leandroassis/laspi-door/Documentação/caixa_de_iluminação_e_fonte_12V.jpeg

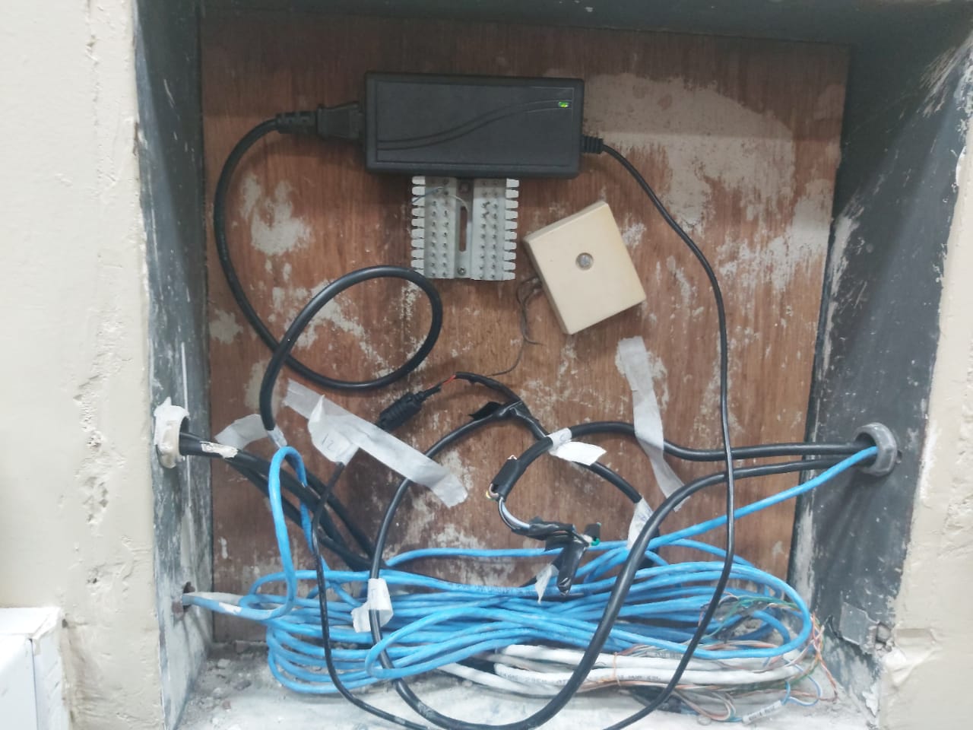
Documentação/caixa_de_iluminação_e_fonte_12V.jpeg
