leandroassis/laspi-door/Documentação/circuito_de_alimentacao_e_relé_de_controle_da_tranca.jpeg

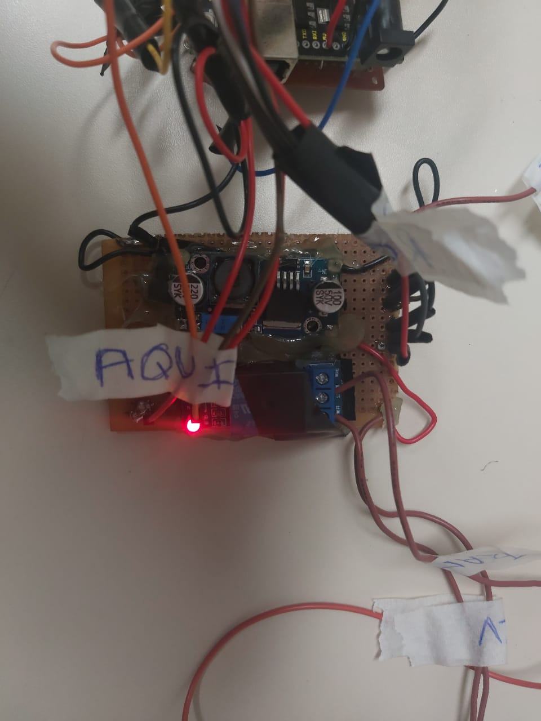
Documentação/circuito_de_alimentacao_e_relé_de_controle_da_tranca.jpeg
