leandroassis/laspi-door/Documentação/Diagrama de ligação da iluminação e fonte de 12V.pdf

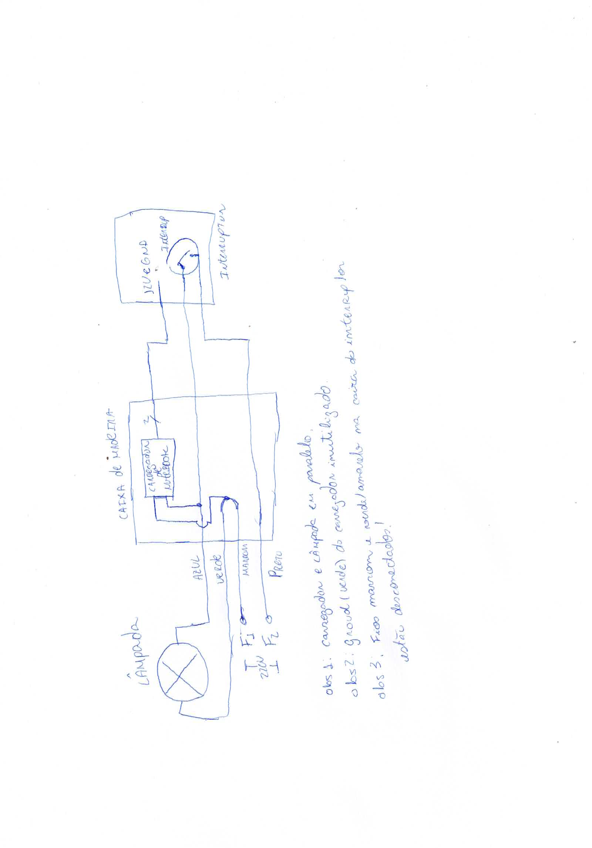
[picture p3: page 1]
