leandroassis/laspi-door/Documentação/Diagrama de ligação do sensor e circuito principal de controle.pdf

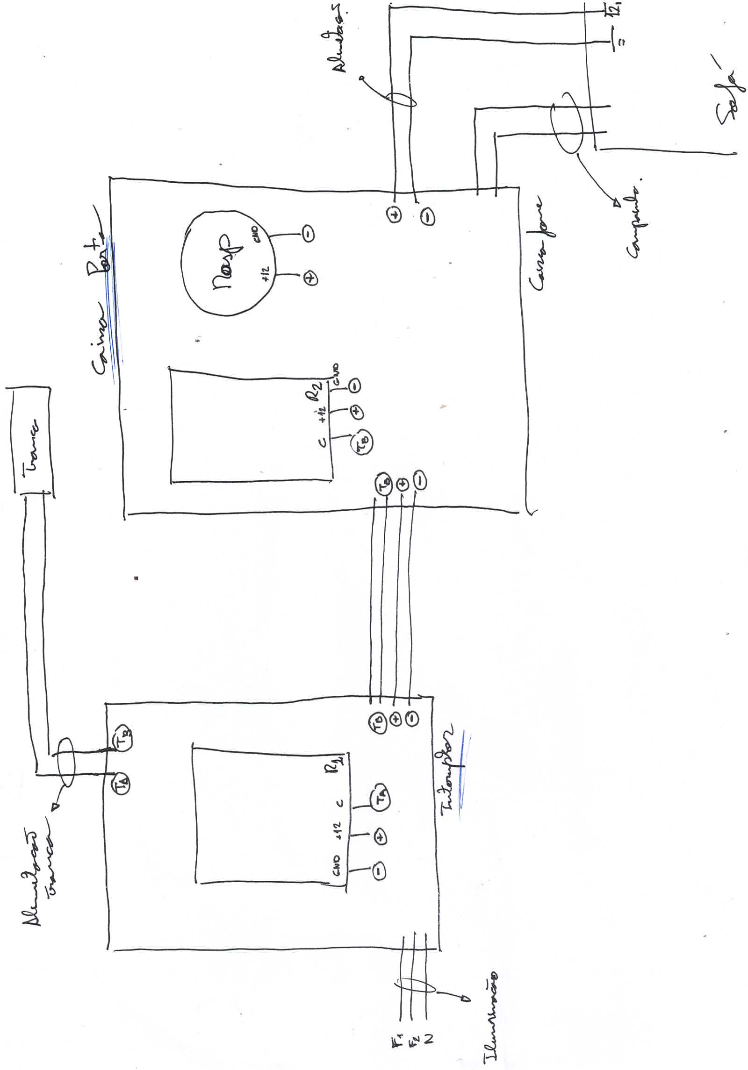
[picture p4: page 1]
