leandroassis/laspi-door/Documentação/sensor_infravermelho.pdf

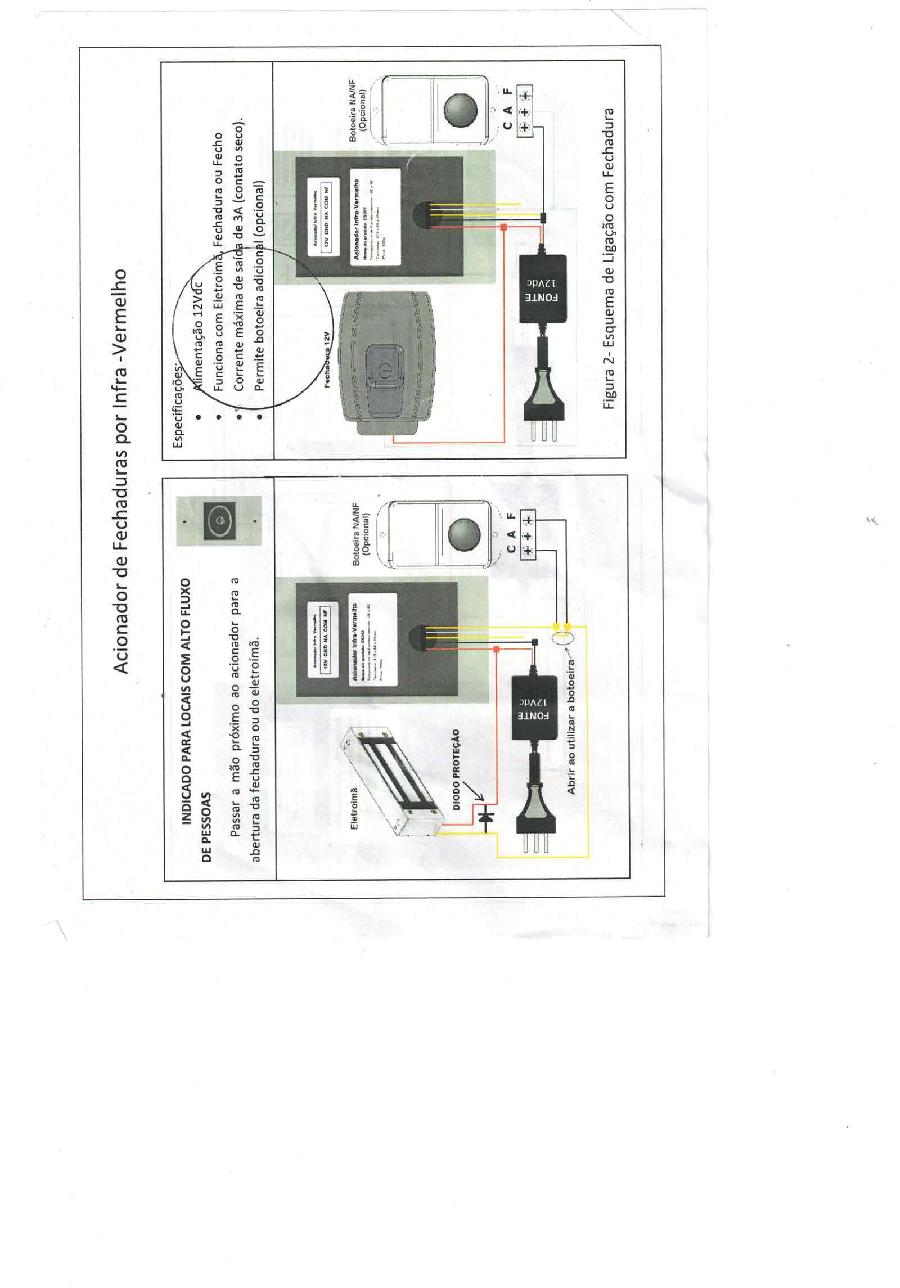
[picture p5: page 1]
