leandroassis/laspi-door/Documentação/circuito_de_redundancia.jpeg

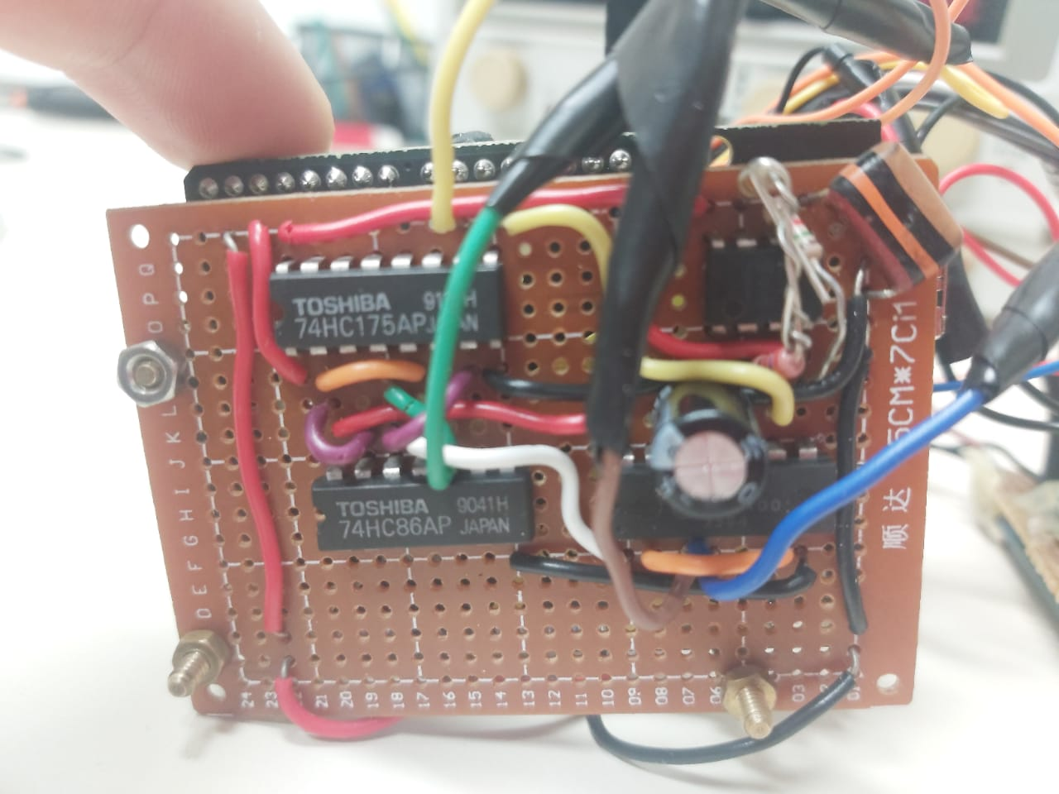
Documentação/circuito_de_redundancia.jpeg
