leandroassis/laspi-door/Documentação/conexões_no_arduino.jpeg

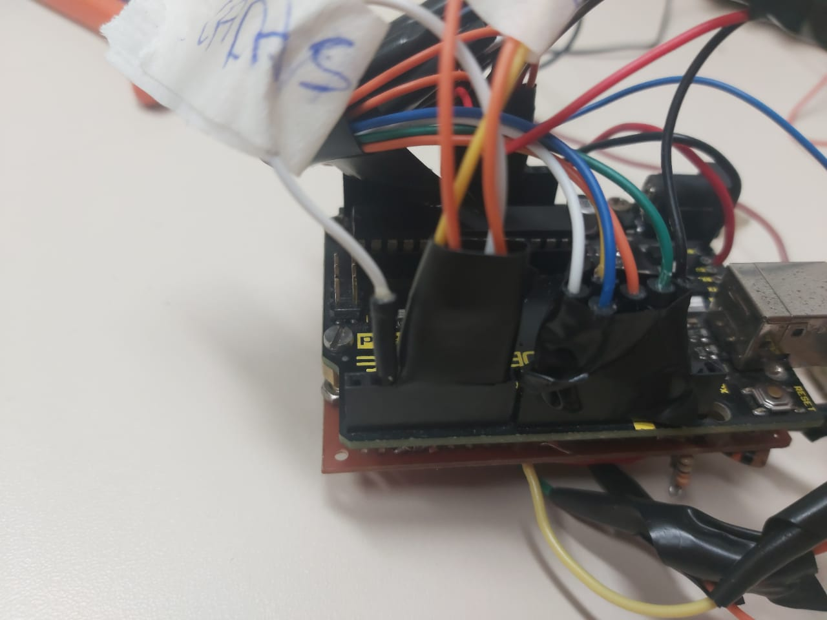
Documentação/conexões_no_arduino.jpeg
