leandroassis/laspi-door/(list of files, drawings)

Other design files:
hardware_controle.dsn
