leandroassis/laspi-door/hardware_controle.kicad_pcb

## KiCad design hardware_controle.kicad_pcb (2023-04-13)

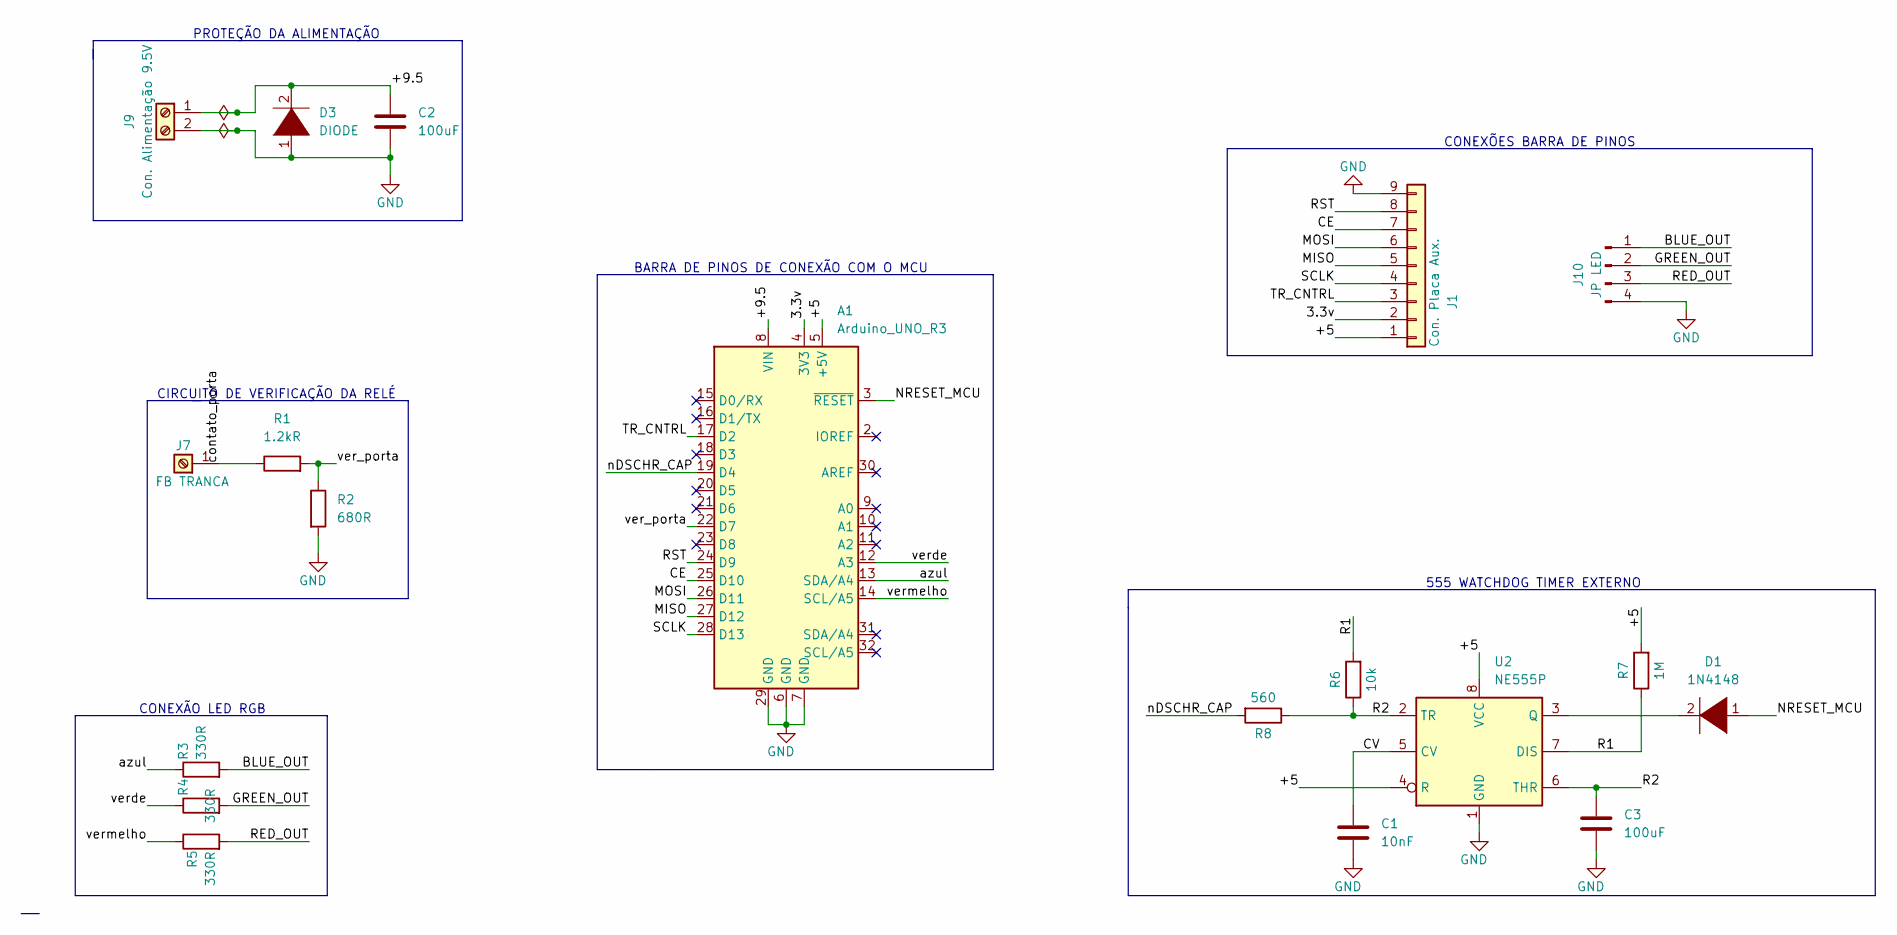
[picture p8: schematic hardware_controle.kicad_sch, Hardware Controle de Acesso]

Parts:
A1: Arduino_UNO_R3
C1: 10nF; C_Radial_D8.0mm_H11.5mm_P3.50mm
C2, C3: 100uF; C_Radial_D8.0mm_H11.5mm_P3.50mm
D1: 1N4148; D_DO-41_SOD81_P7.62mm_Horizontal
D3: DIODE; D_DO-41_SOD81_P7.62mm_Horizontal
J1: Con. Placa Aux.; PinHeader_1x09_P2.54mm_Vertical
J7: FB TRANCA; TerminalBlock_RND_205-00012_1x02_P5.00mm_Horizontal
J9: Con. Alimentação 9.5V; TerminalBlock_RND_205-00012_1x02_P5.00mm_Horizontal
J10: JP LED; PinHeader_1x04_P2.54mm_Vertical
R1: 1.2kR; R_Axial_DIN0207_L6.3mm_D2.5mm_P10.16mm_Horizontal
R2: 680R; R_Axial_DIN0207_L6.3mm_D2.5mm_P10.16mm_Horizontal
R3, R4, R5: 330R; R_Axial_DIN0207_L6.3mm_D2.5mm_P10.16mm_Horizontal
R6: 10k; R_Axial_DIN0207_L6.3mm_D2.5mm_P10.16mm_Horizontal
R7: 1M; R_Axial_DIN0207_L6.3mm_D2.5mm_P10.16mm_Horizontal
R8: 560; R_Axial_DIN0207_L6.3mm_D2.5mm_P10.16mm_Horizontal
U2: NE555P; DIP-8_W7.62mm

Connections:
/3.3v: A1.4 (3V3), J1.2
/+5: A1.5 (+5V), J1.1, R7.2, U2.4 (R), U2.8 (VCC)
/+9.5: A1.8 (VIN), C2.1, D3.2 (A), J9.1
/BLUE_OUT: J10.1, R3.2
/CE: A1.25 (D10), J1.7
/CV: C1.1, U2.5 (CV)
/GREEN_OUT: J10.2, R4.2
/MISO: A1.27 (D12), J1.5
/MOSI: A1.26 (D11), J1.6
/NRESET_MCU: A1.3 (~RESET), D1.1 (K)
/R1: R6.2, R7.1, U2.7 (DIS)
/R2: C3.1, R6.1, R8.1, U2.2 (TR), U2.6 (THR)
/RED_OUT: J10.3, R5.2
/RST: A1.24 (D9), J1.8
/SCLK: A1.28 (D13), J1.4
/TR_CNTRL: A1.17 (D2), J1.3
/azul: A1.13 (SDA/A4), R3.1
/nDSCHR_CAP: A1.19 (D4), R8.2
/ver_porta: A1.22 (D7), R1.2, R2.1
/verde: A1.12 (A3), R4.1
/vermelho: A1.14 (SCL/A5), R5.1
GND: A1.6 (GND), A1.7 (GND), A1.29 (GND), C1.2, C2.2, C3.2, D3.1 (K), J1.9, J9.2, J10.4, R2.2, U2.1 (GND)
unnamed: D1.2 (A), U2.3 (Q)
unnamed: J7.1, R1.1

Notes on the sheet:
CIRCUITO DE VERIFICAÇÃO DA RELÉ
555 WATCHDOG TIMER EXTERNO
BARRA DE PINOS DE CONEXÃO COM O MCU
CONEXÕES BARRA DE PINOS
CONEXÃO LED RGB
PROTEÇÃO DA ALIMENTAÇÃO

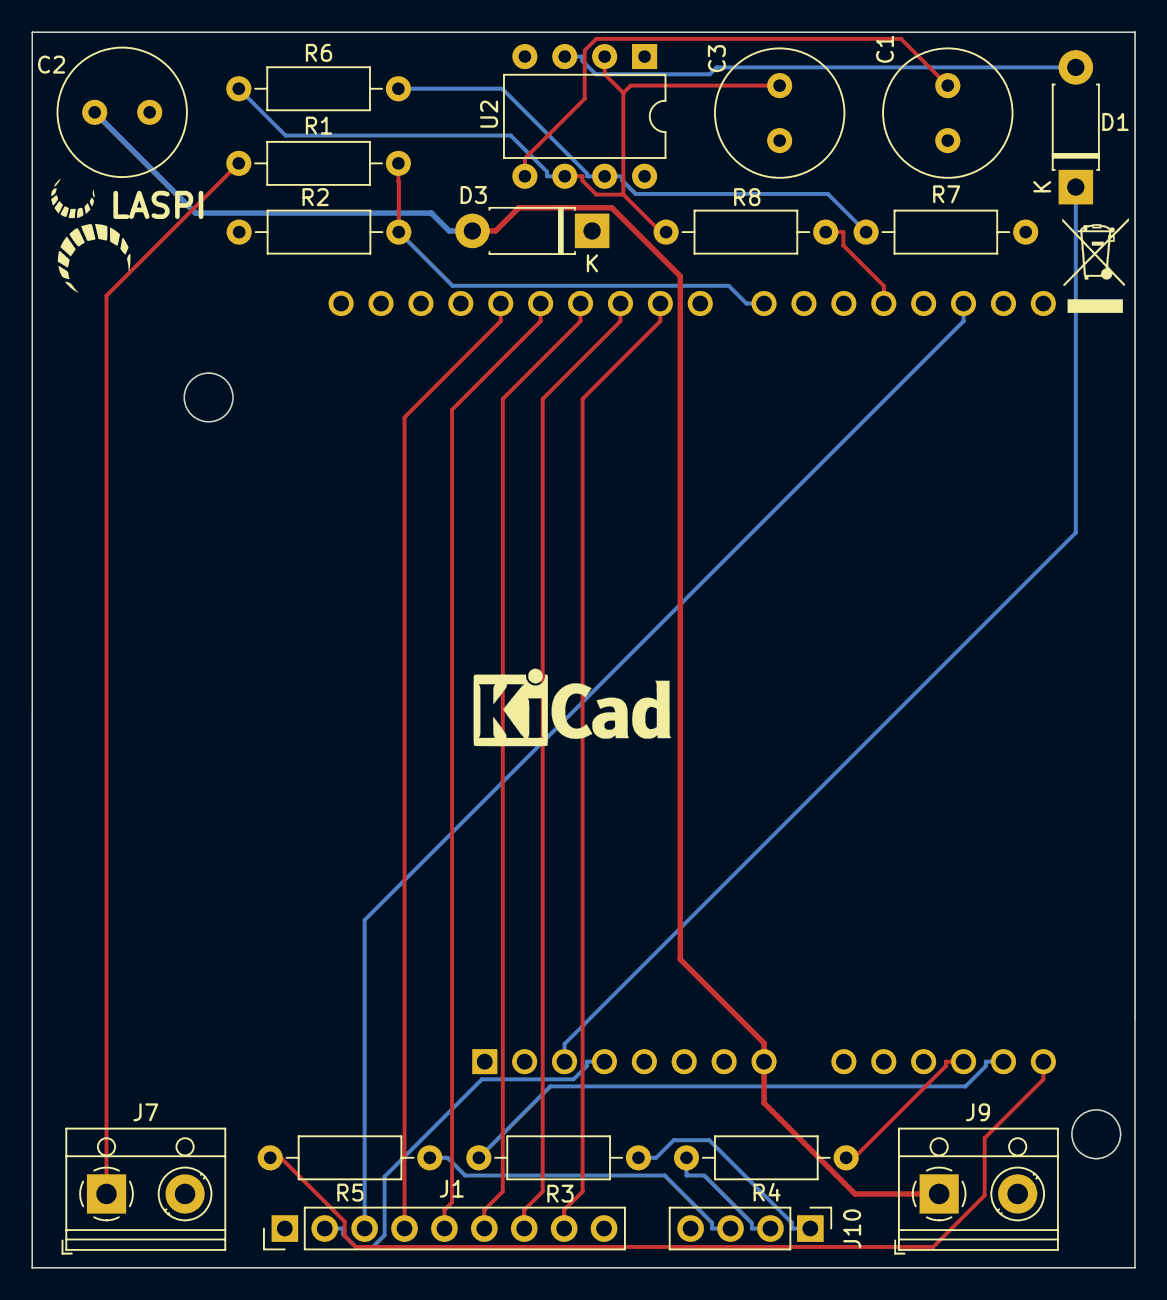
[picture p9: board hardware_controle.kicad_pcb from above]

Board: 4 copper layers, 70.2 x 78.7 mm, 21 parts (1 on the bottom side), 24 nets.

Other parts of the board:
REFe: KiCad-Logo_5mm_SilkScreen
logolaspi: LOGO; laspi
