leandroassis/laspi-door/(commit log)

2022-06-06 Fazendo adição de cadastro e remoção via ethernet
2022-06-07 web socket falhou
2022-06-07 versão com ethernet que cabe no uno
2022-06-08 nada resolvido kk
    [database.csv]
2022-06-10 porta funcionando com interface ethernet
    [database.csv]
2022-06-28 adição da descrição textual e inicio do código do cerberus
    [Planilha acesso as salas .xlsx, database.csv]
2023-01-04 remoção de arquivos ultrapassados
2023-01-04 schema refeito: pwr+pinout+tranca+ver. relé
    [hardware_controle.kicad_pcb, hardware_controle.kicad_sch]
2023-01-04 refatorado: falta adicionar logica de comun
2023-01-09 iniciando server
    [database.csv]
2023-01-09 removendo arquivos inuteis
    [database.csv, hardware_controle.kicad_pcb, hardware_controle.kicad_sch]
2023-01-09 portal de login com carcaça
